spe-khe/Wordclock_mini/docs/assets/Mini_Wordclock_complete.3mf

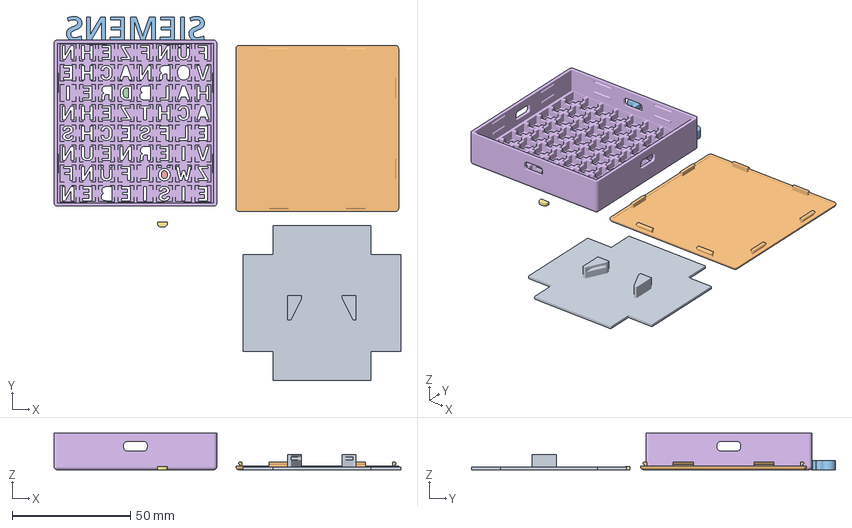
[picture p1: CAD file, 2026-08-18, last stored version]
docs/assets/Mini_Wordclock_complete.3mf
147.0 x 154.2 x 15.6 mm
Mini_wordclock_Montageplatte.3mf
Mini_Wordclock_Back.3mf
Mini_wordclock_Front_V2.3mf(14)
Mini_wordclock_Front_V2.3mf(7)
Mini_wordclock_Front_V2.3mf(5)
Mini_wordclock_Front_V2.3mf
Mini_Wordclock_Front_V2.3mf(8)
